violalalaa/STM32-FreeRTOS-EnvironmentalMonitor/Core/Src/main.c

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
/* Includes ------------------------------------------------------------------*/
#include "main.h"
#include "cmsis_os.h"
#include "dht.h"
#include "oled.h"
#include "delay.h"
#include "stdint.h"
#include "stdio.h"
/* USER CODE BEGIN Includes */
#include "power.h"
#include "esp8266.h"
/* USER CODE END Includes */

I2C_HandleTypeDef hi2c1;

IWDG_HandleTypeDef hiwdg;

UART_HandleTypeDef huart1;
UART_HandleTypeDef huart2;

/* Definitions for DHT_Task */
osThreadId_t DHT_TaskHandle;
const osThreadAttr_t DHT_Task_attributes = {
  .name = "DHT_Task",
  .stack_size = 256 * 4,
  .priority = (osPriority_t) osPriorityHigh,
};
/* Definitions for OLED_Task */
osThreadId_t OLED_TaskHandle;
const osThreadAttr_t OLED_Task_attributes = {
  .name = "OLED_Task",
  .stack_size = 256 * 4,
  .priority = (osPriority_t) osPriorityNormal,
};
/* Definitions for Key_Task */
osThreadId_t Key_TaskHandle;
const osThreadAttr_t Key_Task_attributes = {
  .name = "Key_Task",
  .stack_size = 256 * 4,
  .priority = (osPriority_t) osPriorityAboveNormal,
};
/* Definitions for WiFi_Task */
osThreadId_t WiFi_TaskHandle;
const osThreadAttr_t WiFi_Task_attributes = {
  .name = "WiFi_Task",
  .stack_size = 256 * 4,
  .priority = (osPriority_t) osPriorityLow,
};
/* Definitions for StatusLEDTask */
osThreadId_t StatusLEDTaskHandle;
const osThreadAttr_t StatusLEDTask_attributes = {
  .name = "StatusLEDTask",
  .stack_size = 128 * 4,
  .priority = (osPriority_t) osPriorityLow,
};
/* Definitions for WatchDogTask */
osThreadId_t WatchDogTaskHandle;
const osThreadAttr_t WatchDogTask_attributes = {
  .name = "WatchDogTask",
  .stack_size = 256 * 4,
  .priority = (osPriority_t) osPriorityAboveNormal,
};
/* Definitions for Queue_OLED */
osMessageQueueId_t Queue_OLEDHandle;
const osMessageQueueAttr_t Queue_OLED_attributes = {
  .name = "Queue_OLED"
};
/* Definitions for Queue_WiFi */
osMessageQueueId_t Queue_WiFiHandle;
const osMessageQueueAttr_t Queue_WiFi_attributes = {
  .name = "Queue_WiFi"
};
/* Definitions for Sem_Key */
osSemaphoreId_t Sem_KeyHandle;
const osSemaphoreAttr_t Sem_Key_attributes = {
  .name = "Sem_Key"
};
void SystemClock_Config(void);
static void MX_GPIO_Init(void);
static void MX_I2C1_Init(void);
static void MX_USART1_UART_Init(void);
static void MX_USART2_UART_Init(void);
static void MX_IWDG_Init(void);
void StartDHTTask(void *argument);
void StartOLEDTask(void *argument);
void StartKeyTask(void *argument);
void StartWiFiTask(void *argument);
void StartStatusLEDTask(void *argument);
void StartWatchDogTask(void *argument);

/**
  * @brief  The application entry point.
  * @retval int
  */
int main(void)
{

  /* MCU Configuration--------------------------------------------------------*/

  /* Reset of all peripherals, Initializes the Flash interface and the Systick. */
  HAL_Init();

  /* Configure the system clock */
  SystemClock_Config();

  /* Initialize all configured peripherals */
  MX_GPIO_Init();
  MX_I2C1_Init();
  MX_USART1_UART_Init();
  MX_USART2_UART_Init();
  MX_IWDG_Init();
  /* USER CODE BEGIN 2 */
    OLED_Init();
		delay_init();
    ESP8266_Init();
    Power_LogResetReason();
    Power_Init();
  	HAL_IWDG_Refresh(&hiwdg);
    __HAL_DBGMCU_FREEZE_IWDG();
  /* USER CODE END 2 */

  /* Init scheduler */
  osKernelInitialize();

  /* USER CODE BEGIN RTOS_MUTEX */
  /* add mutexes, ... */
  /* USER CODE END RTOS_MUTEX */

  /* Create the semaphores(s) */
  /* creation of Sem_Key */
  Sem_KeyHandle = osSemaphoreNew(1, 1, &Sem_Key_attributes);

  /* USER CODE BEGIN RTOS_SEMAPHORES */
  /* add semaphores, ... */
  /* USER CODE END RTOS_SEMAPHORES */

  /* USER CODE BEGIN RTOS_TIMERS */
  /* start timers, add new ones, ... */
  /* USER CODE END RTOS_TIMERS */

  /* Create the queue(s) */
  /* creation of Queue_OLED */
  Queue_OLEDHandle = osMessageQueueNew (1, sizeof(DHT_Data_t), &Queue_OLED_attributes);

  /* creation of Queue_WiFi */
  Queue_WiFiHandle = osMessageQueueNew (3, sizeof(DHT_Data_t), &Queue_WiFi_attributes);

  /* USER CODE BEGIN RTOS_QUEUES */
  /* add queues, ... */
  /* USER CODE END RTOS_QUEUES */

  /* Create the thread(s) */
  /* creation of DHT_Task */
  DHT_TaskHandle = osThreadNew(StartDHTTask, NULL, &DHT_Task_attributes);

  /* creation of OLED_Task */
  OLED_TaskHandle = osThreadNew(StartOLEDTask, NULL, &OLED_Task_attributes);

  /* creation of Key_Task */
  Key_TaskHandle = osThreadNew(StartKeyTask, NULL, &Key_Task_attributes);

  /* creation of WiFi_Task */
  WiFi_TaskHandle = osThreadNew(StartWiFiTask, NULL, &WiFi_Task_attributes);

  /* creation of StatusLEDTask */
  StatusLEDTaskHandle = osThreadNew(StartStatusLEDTask, NULL, &StatusLEDTask_attributes);

  /* creation of WatchDogTask */
  WatchDogTaskHandle = osThreadNew(StartWatchDogTask, NULL, &WatchDogTask_attributes);

  /* USER CODE BEGIN RTOS_THREADS */
  /* add threads, ... */
  /* USER CODE END RTOS_THREADS */

  /* USER CODE BEGIN RTOS_EVENTS */
  /* add events, ... */
  /* USER CODE END RTOS_EVENTS */

  /* Start scheduler */
  osKernelStart();

  /* We should never get here as control is now taken by the scheduler */

  /* Infinite loop */
  /* USER CODE BEGIN WHILE */
  while (1)
  {
    /* USER CODE END WHILE */

    /* USER CODE BEGIN 3 */
  }
  /* USER CODE END 3 */
}

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
/* USER CODE BEGIN Header_StartDHTTask */
/**
  * @brief  Function implementing the DHT_Task thread.
  * @param  argument: Not used
  * @retval None
  */
/* USER CODE END Header_StartDHTTask */
__weak void StartDHTTask(void *argument)
{
  /* USER CODE BEGIN 5 */
  /* Infinite loop */
  for(;;)
  {
    osDelay(1);
  }
  /* USER CODE END 5 */
}

/* USER CODE BEGIN Header_StartOLEDTask */
/**
* @brief Function implementing the OLED_Task thread.
* @param argument: Not used
* @retval None
*/
/* USER CODE END Header_StartOLEDTask */
__weak void StartOLEDTask(void *argument)
{
  /* USER CODE BEGIN StartOLEDTask */
  /* Infinite loop */
  for(;;)
  {
    osDelay(1);
  }
  /* USER CODE END StartOLEDTask */
}

/* USER CODE BEGIN Header_StartKeyTask */
/**
* @brief Function implementing the Key_Task thread.
* @param argument: Not used
* @retval None
*/
/* USER CODE END Header_StartKeyTask */
__weak void StartKeyTask(void *argument)
{
  /* USER CODE BEGIN StartKeyTask */
  /* Infinite loop */
  for(;;)
  {
    osDelay(1);
  }
  /* USER CODE END StartKeyTask */
}

/* USER CODE BEGIN Header_StartWiFiTask */
/**
* @brief Function implementing the WiFi_Task thread.
* @param argument: Not used
* @retval None
*/
/* USER CODE END Header_StartWiFiTask */
__weak void StartWiFiTask(void *argument)
{
  /* USER CODE BEGIN StartWiFiTask */
  /* Infinite loop */
  for(;;)
  {
    osDelay(1);
  }
  /* USER CODE END StartWiFiTask */
}

/* USER CODE BEGIN Header_StartStatusLEDTask */
/**
* @brief Function implementing the StatusLEDTask thread.
* @param argument: Not used
* @retval None
*/
/* USER CODE END Header_StartStatusLEDTask */
__weak void StartStatusLEDTask(void *argument)
{
  /* USER CODE BEGIN StartStatusLEDTask */
  /* Infinite loop */
  for(;;)
  {
    osDelay(1);
  }
  /* USER CODE END StartStatusLEDTask */
}

/* USER CODE BEGIN Header_StartWatchDogTask */
/**
* @brief Function implementing the WatchDogTask thread.
* @param argument: Not used
* @retval None
*/
/* USER CODE END Header_StartWatchDogTask */
__weak void StartWatchDogTask(void *argument)
{
  /* USER CODE BEGIN StartWatchDogTask */
  /* Infinite loop */
  for(;;)
  {
    osDelay(1);
  }
  /* USER CODE END StartWatchDogTask */
}

/**
  * @brief  Period elapsed callback in non blocking mode
  * @note   This function is called  when TIM4 interrupt took place, inside
  * HAL_TIM_IRQHandler(). It makes a direct call to HAL_IncTick() to increment
  * a global variable "uwTick" used as application time base.
  * @param  htim : TIM handle
  * @retval None
  */
void HAL_TIM_PeriodElapsedCallback(TIM_HandleTypeDef *htim)
{
  if (htim->Instance == TIM4)
  {
    HAL_IncTick();
  }
}

/**
  * @brief  This function is executed in case of error occurrence.
  * @retval None
  */
void Error_Handler(void)
{
  /* USER CODE BEGIN Error_Handler_Debug */
  /* User can add his own implementation to report the HAL error return state */
  __disable_irq();
  while (1)
  {
  }
  /* USER CODE END Error_Handler_Debug */
}
#ifdef USE_FULL_ASSERT
/**
  * @brief  Reports the name of the source file and the source line number
  *         where the assert_param error has occurred.
  * @param  file: pointer to the source file name
  * @param  line: assert_param error line source number
  * @retval None
  */
void assert_failed(uint8_t *file, uint32_t line)
{
  /* USER CODE BEGIN 6 */
  /* User can add his own implementation to report the file name and line number,
     ex: printf("Wrong parameters value: file %s on line %d\r\n", file, line) */
  /* USER CODE END 6 */
}
#endif /* USE_FULL_ASSERT */
