violalalaa/STM32-FreeRTOS-EnvironmentalMonitor/Core/Inc/main.h

#define DHT_DAT_Pin GPIO_PIN_1
#define DHT_DAT_GPIO_Port GPIOA
#define KEY0_Pin GPIO_PIN_11
#define KEY0_GPIO_Port GPIOA
#define KEY0_EXTI_IRQn EXTI15_10_IRQn
