violalalaa/STM32-FreeRTOS-EnvironmentalMonitor/user/user.c

#include "stm32f1xx_hal.h"
#include "stdint.h"
#include "stdio.h"
#include "dht.h"
#include "oled.h"
#include "cmsis_os.h"
#include "esp8266.h"
#include "power.h"
#include "FreeRTOS.h"
#include "task.h"
#define KEY0_Pin       GPIO_PIN_11
#define KEY0_GPIO_Port GPIOA
extern osSemaphoreId_t Sem_KeyHandle;
extern osMessageQueueId_t Queue_OLEDHandle;
extern osMessageQueueId_t Queue_WiFiHandle;
extern UART_HandleTypeDef huart1;
extern IWDG_HandleTypeDef hiwdg;
extern volatile uint8_t g_wakeup_by_key;
volatile uint8_t g_dht_error_count = 0;
volatile uint8_t g_wifi_error_count = 0;
volatile uint32_t g_heartbeat_dht  = 0;
volatile uint32_t g_heartbeat_oled = 0;
volatile uint32_t g_heartbeat_key  = 0;
volatile uint32_t g_heartbeat_wifi = 0;

extern osThreadId_t DHT_TaskHandle;
extern osThreadId_t OLED_TaskHandle;
extern osThreadId_t Key_TaskHandle;
extern osThreadId_t WiFi_TaskHandle;

void ESP8266_NotifyAlive(void)
{
    g_heartbeat_wifi = osKernelGetTickCount();
}
int fputc(int ch, FILE *f) {
    HAL_UART_Transmit(&huart1, (uint8_t *)&ch, 1, 0xFFFF); 
    return ch;
}
 void StartKeyTask(void *argument) {
    uint32_t press_start_tick = 0;
    uint8_t is_pressed = 0;
    for(;;) {
        g_heartbeat_key = osKernelGetTickCount();
        if (HAL_GPIO_ReadPin(KEY0_GPIO_Port, KEY0_Pin) == 0) {
            if (!is_pressed) {
                is_pressed = 1;
                press_start_tick = osKernelGetTickCount();
            }
        } else {
            if (is_pressed) {
                uint32_t press_duration = osKernelGetTickCount() - press_start_tick;
                if (press_duration < 2000) {
                    osSemaphoreRelease(Sem_KeyHandle); // 短按翻页
                }
                is_pressed = 0;
            }
        }
        if (is_pressed && (osKernelGetTickCount() - press_start_tick >= 2000)) {
            Enter_StopMode();  // 进去睡眠，唤醒后从这里继续
            is_pressed = 0;
            osDelay(300);      // 等手指完全松开
            continue;
        }

        osDelay(20); 
    }
}
void StartDHTTask(void *argument)
{
    DHT_Data_t dht_data;
    int8_t ret;
    for(;;)
    {
			 g_heartbeat_dht = osKernelGetTickCount();
        // 直接调用已经带临界区保护的DHT_Read_Data
        ret = DHT_Read_Data(&dht_data);
        if (ret == 0) // 读取成功
        {
            taskENTER_CRITICAL();
            g_dht_error_count = 0; // 成功一次就清零
            taskEXIT_CRITICAL();
					// 这里已经出了临界区，可以安全调用队列 API
            if (osMessageQueuePut(Queue_OLEDHandle, &dht_data, 0, 10) != osOK)
            {
                // printf("OLED Queue full!\r\n");可前期做调试用
            }
            if (osMessageQueuePut(Queue_WiFiHandle, &dht_data, 0, 10) != osOK)
            {
                // printf("WiFi Queue full!\r\n");可前期做调试用
            }
        }
        else
        {
           taskENTER_CRITICAL();
            g_dht_error_count++;
            taskEXIT_CRITICAL(); 
            // 读取失败  printf("DHT11 err: %d\r\n", ret);可前期做调试用
        }
        osDelay(1500); 
    }
}
void StartOLEDTask(void *argument) {
    DHT_Data_t oled_data = {0};          
    static uint8_t current_page = 0;
    char temp_str[20] = "--.-";         
    char humi_str[20] = "--.-";
    uint8_t need_update = 0;
    for(;;) {
			g_heartbeat_oled = osKernelGetTickCount();
        need_update = 0;
        if (osSemaphoreAcquire(Sem_KeyHandle, 0) == osOK) {
            current_page = !current_page;
            printf("Key pressed! Switch page.\r\n");
            need_update = 1;             // 按键肯定会刷新
        }
        if (osMessageQueueGet(Queue_OLEDHandle, &oled_data, 0, 0) == osOK) {
            // 只有成功拿到数据才更新字符串
            snprintf(temp_str, sizeof(temp_str), "%.1f", oled_data.temperature);
            snprintf(humi_str, sizeof(humi_str), "%.1f", oled_data.humidity);
            need_update = 1;
        }
        if (need_update) {
            OLED_Clear();
            if (current_page == 0) {
                OLED_ShowString(2, 1, "Temp: ");
                OLED_ShowString(2, 2, temp_str);
                OLED_ShowString(3, 1, "Humi: ");
                OLED_ShowString(3, 2, humi_str);
            } else {
                OLED_ShowString(1, 1, "WiFi:");
                OLED_ShowNum(1, 7, g_wifi_error_count, 2);
                OLED_ShowString(2, 1, "DHT:");
                OLED_ShowNum(2, 7, g_dht_error_count, 2);
                OLED_ShowString(3, 1, "Join:");
                OLED_ShowNum(3, 7, ESP8266_FailStreak(), 2);
            }
        }
        osDelay(500);
    }
}
void StartWiFiTask(void *argument) {
    DHT_Data_t wifi_data;
    char send_buf[48];
    g_heartbeat_wifi = osKernelGetTickCount();
    for(;;) {
        g_heartbeat_wifi = osKernelGetTickCount();
        if (ESP8266_Poll() == 1) {
            if (osMessageQueueGet(Queue_WiFiHandle, &wifi_data, NULL, 1000) == osOK) {
                snprintf(send_buf, sizeof(send_buf), "Temp:%.1f,Humi:%.1f",
                         wifi_data.temperature, wifi_data.humidity);
                if (ESP8266_SendData(send_buf) != 0) {
                    g_wifi_error_count++;
                    printf("TCP send fail, reconnect\r\n");
                } else {
                    g_wifi_error_count = 0;
                }
            }
        } else {
            osDelay(20);
        }
    }
}  
void StartStatusLEDTask(void *argument) {
    for(;;) {
        if ((g_wifi_error_count >= 3) || (ESP8266_FailStreak() >= 3)) {
            for(int i=0; i<5; i++) {
                HAL_GPIO_WritePin(GPIOC, GPIO_PIN_13, GPIO_PIN_RESET); // 亮
                osDelay(100);
                HAL_GPIO_WritePin(GPIOC, GPIO_PIN_13, GPIO_PIN_SET);   // 灭
                osDelay(100);
            }
            osDelay(2000); // 停 2 秒再循环
        }
        else if (g_dht_error_count >= 3) { // DHT 连续失败 3 次：慢闪 3 下
            for(int i=0; i<3; i++) {
                HAL_GPIO_WritePin(GPIOC, GPIO_PIN_13, GPIO_PIN_RESET);
                osDelay(300);
                HAL_GPIO_WritePin(GPIOC, GPIO_PIN_13, GPIO_PIN_SET);
                osDelay(300);
            }
            osDelay(2000);
        }
        else {  // 正常心跳：每秒闪一次         
            HAL_GPIO_WritePin(GPIOC, GPIO_PIN_13, GPIO_PIN_RESET);
            osDelay(100);
            HAL_GPIO_WritePin(GPIOC, GPIO_PIN_13, GPIO_PIN_SET);
            osDelay(900);
        }
    }
}
void StartWatchDogTask(void *argument)
{
    uint32_t now;
    uint8_t mark_div = 0;
    for(;;)
    {
        now = osKernelGetTickCount();
        if ((now - g_heartbeat_dht  < 5000) &&
            (now - g_heartbeat_oled < 5000) &&
            (now - g_heartbeat_key  < 5000) &&
            (now - g_heartbeat_wifi < 5000))
        {
            HAL_IWDG_Refresh(&hiwdg);
        }
        if (++mark_div >= 20) {
            mark_div = 0;
            printf("HW DHT=%lu OLED=%lu KEY=%lu WIFI=%lu\r\n",
                   (unsigned long)uxTaskGetStackHighWaterMark((TaskHandle_t)DHT_TaskHandle),
                   (unsigned long)uxTaskGetStackHighWaterMark((TaskHandle_t)OLED_TaskHandle),
                   (unsigned long)uxTaskGetStackHighWaterMark((TaskHandle_t)Key_TaskHandle),
                   (unsigned long)uxTaskGetStackHighWaterMark((TaskHandle_t)WiFi_TaskHandle));
        }
        osDelay(500);
    }
}
void HAL_GPIO_EXTI_Callback(uint16_t GPIO_Pin)
{
    if (GPIO_Pin == GPIO_PIN_11) {
        g_wakeup_by_key = 1; // 唤醒标志
    }
}
