violalalaa/STM32-FreeRTOS-EnvironmentalMonitor/(commit log)

2026-08-02 第一版完整工程
2026-08-02 上传完整代码
2026-08-03 更新 README 说明文档
2026-09-06 新增看门狗与低功耗
2026-09-06 更新readme说明文档
2026-10-01 优化代码
2026-10-01 解决看门狗和低功耗打架的问题
